cetola/pocket-reform-mirror/pocket-reform-keyboard-case/pref-kbd-stdalone-20261014-plate15.step

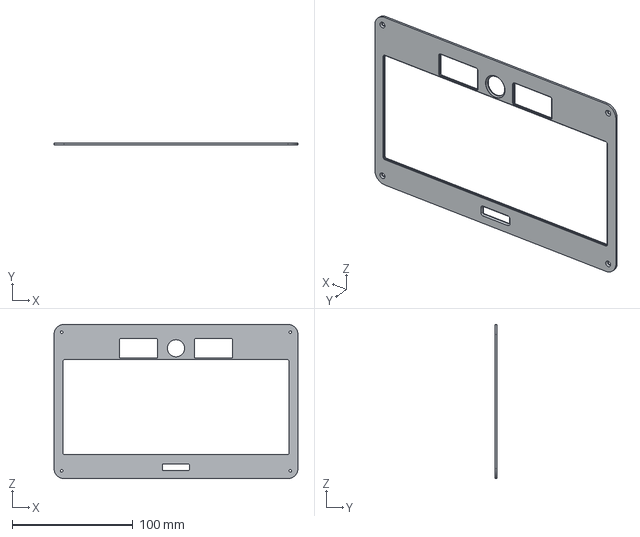
[picture p1: CAD file, 2026-10-14]
pocket-reform-keyboard-case/pref-kbd-stdalone-20261014-plate15.step
202.2 x 1.50 x 127.8 mm
