cetola/pocket-reform-mirror/pocket-reform-motherboard/3d-models/HDMI-SMD_BX-HDMI-2-M19P.step

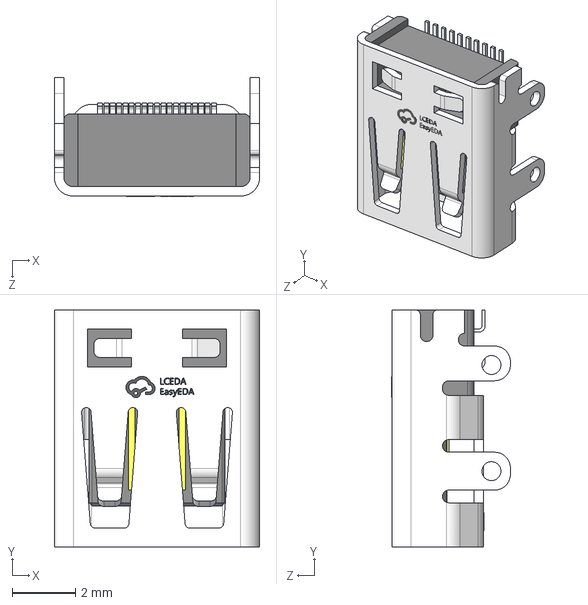
[picture p2: CAD file, 2026-08-06]
pocket-reform-motherboard/3d-models/HDMI-SMD_BX-HDMI-2-M19P.step
6.50 x 7.50 x 3.76 mm
