cetola/pocket-reform-mirror/pocket-reform-keyboard-case/pref-kbd-plate-20260616.step

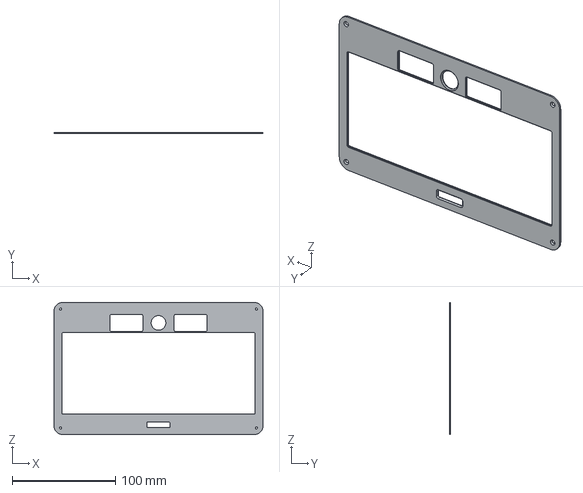
[picture p3: CAD file, 2026-10-09]
pocket-reform-keyboard-case/pref-kbd-plate-20260616.step
202.2 x 1.30 x 127.8 mm
