cetola/pocket-reform-mirror/pocket-reform-motherboard/3d-models/RET0040A.stp

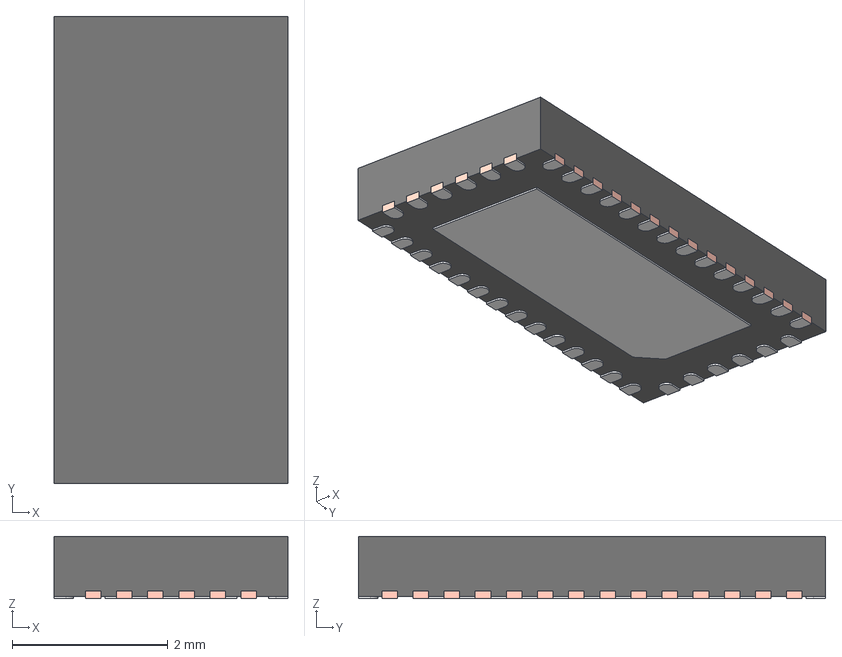
[picture p4: CAD file, 2026-08-06]
pocket-reform-motherboard/3d-models/RET0040A.stp
3.00 x 6.00 x 0.8 mm
RET0040A_FRAME
RET0040A_BODY
RET0040A_PIN1_AREA
