cetola/pocket-reform-mirror/pocket-reform-motherboard/3d-models/FUSB302BMPX.STEP

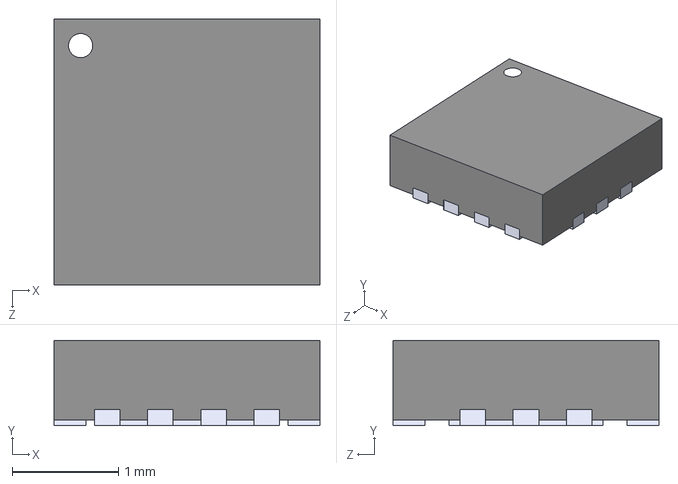
[picture p5: CAD file, 2026-08-06]
pocket-reform-motherboard/3d-models/FUSB302BMPX.STEP
2.50 x 0.8 x 2.50 mm
