cetola/pocket-reform-mirror/pocket-reform-motherboard/3d-models/LM73100RPWR.step

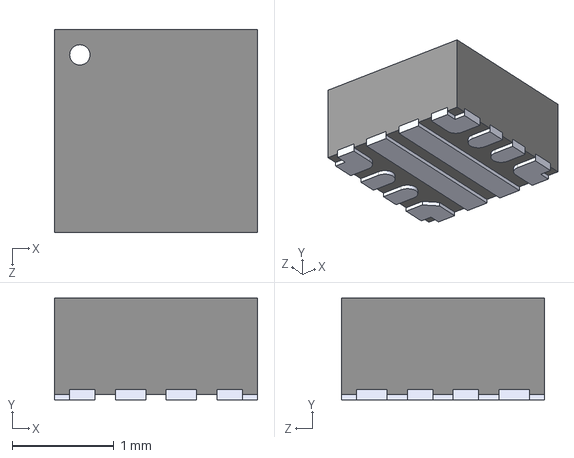
[picture p6: CAD file, 2026-08-06]
pocket-reform-motherboard/3d-models/LM73100RPWR.step
2.00 x 1.00 x 2.00 mm
