cetola/pocket-reform-mirror/pocket-reform-motherboard/3d-models/LM62460QRPHRQ1.step

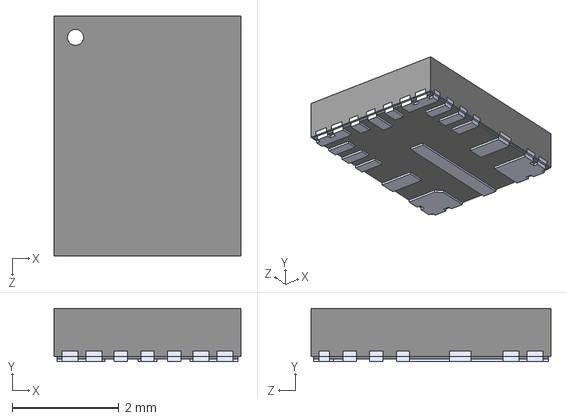
[picture p7: CAD file, 2026-08-06]
pocket-reform-motherboard/3d-models/LM62460QRPHRQ1.step
3.50 x 1.00 x 4.50 mm
