cetola/pocket-reform-mirror/pocket-reform-motherboard/pocket-reform-motherboard.kicad_pcb

## KiCad design pocket-reform-motherboard/pocket-reform-motherboard.kicad_pcb (2026-07-01)

Schematic: pocket-reform-motherboard.kicad_sch, MNT Pocket Reform

Parts:
C1, C3, C13, C19, C20, C25, C27, C28, C29, C30, C31, C32, C33, C34, C35, C38, C40, C42, C43, C44, C45, C46, C48, C49, C50, C53, C54, C55, C57, C59, C60, C61, C62, C63, C64, C66, C68, C69, C70, C71, C72, C73, C74, C75, C76, C77, C78, C79, C80, C81, C84, C87, C95, C97, C99, C101, C104, C108, C109, C121, C127, C128, C130, C131, C132, C137, C138, C142, C143, C144, C145, C148, C151, C154, C155, C156: 0.1uF; C_0402_1005Metric; LCSC C307331
C2, C7, C12, C39, C47, C51, C56, C58, C65, C98, C105, C107, C112, C115, C129, C133, C136, C141, C152, C153, C157, C158: 10uF; C_0603_1608Metric; LCSC C194427
C4: 22uF; C_Elec_4x5.4; LCSC C3830031
C5: 47uF; CP_Elec_6.3x5.8; LCSC C688950
C6, C14, C15, C16, C17, C18, C116, C117, C118, C119, C120, C134: 22uF; C_0603_1608Metric; LCSC C86295
C8, C11, C82, C113, C114: 470nF; C_0603_1608Metric; LCSC C1623
C9, C10: 4.7uF; C_0603_1608Metric; LCSC C437419
C21, C23: 18pF; C_0402_1005Metric; LCSC C1549
C22, C24: 15pF; C_0402_1005Metric; LCSC C161530
C26, C36, C111, C125, C147: 1uF; C_0402_1005Metric; LCSC C52923
C37: 1nF; C_0402_1005Metric; LCSC C1523
C41, C146: 4.7uF; C_0402_1005Metric; LCSC C23733
C52: 10nF; C_0603_1608Metric; LCSC C1589
C67, C106: 22uF; C_0805_2012Metric; LCSC C45783
C83, C123, C124, C126: 47uF; C_0603_1608Metric; LCSC C140782
C85, C86, C88, C89, C90, C91, C92, C93: 0.22uF; C_0402_1005Metric; LCSC C1525
C94, C100: 10uF; C_0402_1005Metric; LCSC C315248
C96: DNP; C_0402_1005Metric; LCSC C1525; not fitted
C102, C103, C135: 47uF; C_1206_3216Metric; LCSC C94034
C110, C122: 10pF; C_0402_1005Metric; LCSC C32949
D1, D8, D9, D23: LED_RED; LED_0603_1608Metric; LCSC C965799
D2: ESDS314; SOT-23-5; LCSC C1847859
D3: MS2A40LWS; D_SOD-323; LCSC C7380001
D5: PMEG4050EP-FS; D_SOD-128; LCSC C42387310
D10: 19-337/R6GHBHC-A01/2T; LED_19-337_R6GHBHC-A01_2T; LCSC C264519
D12: SD0603S040S0R2; D_0603_1608Metric; LCSC C143772
FB2, FB9, FB10, FB12, FB13, FB14, FB15, FB16: 100@100MHz 3A; L_0603_1608Metric; LCSC C14709
FB5: DNP; L_0603_1608Metric; LCSC C14709; not fitted
GFX1: MountingHole; pocket-reform; LCSC DNP; not fitted
GFX2: MountingHole; pref-motherboard-badge; LCSC DNP; not fitted
H1, H2, H3, H4: MountingHole_Pad; MountingHole_2.2mm_M2_DIN965_Pad; LCSC DNP; not fitted
H5, H7: NGFF-Mount1; WA-SMSI-M2; LCSC C18198647
H8, H9: MountingHole_Pad; WA-SMSI-M2; LCSC C22431115
J1: CHARGER; JST_PH_S9B-PH-SM4-TB_1x09-1MP_P2.00mm_Horizontal; LCSC C278795
J2: DM3AT-SF-PEJM5; LCSC C114218
J3, J14: USB_C_Receptacle; MOLEX_105450-0101; LCSC C134092
J4: 09452812561; LCSC C19193264
J5: SYSCTL; JST_SH_SM04B-SRSS-TB_1x04-1MP_P1.00mm_Horizontal; LCSC C160404
J6: USB_INT1; JST_SH_SM04B-SRSS-TB_1x04-1MP_P1.00mm_Horizontal; LCSC C160404
J7: HDMI_D_1.4; HDMI-SMD_BX-HDMI-2-M19P; LCSC C18077696
J8: SIM_Card; MOLEX_78800-0001; LCSC C127364
J9: Conn_01x20; Hirose_FH12-20S-0.5SH_1x20-1MP_P0.50mm_Horizontal; LCSC C2906119
J10: 1-2199230-6; TE_1-2199230-6; LCSC C4710843
J11: Conn_01x33; Hirose_FH12-33S-0.5SH_1x33-1MP_P0.50mm_Horizontal; LCSC C19077727
J12: 2199230-5; TE_2199230-5; LCSC C4827729
J13: 3-2328724-1; TE_3-2328724-1; LCSC C52722586
J15: CONN_SPK; Molex_PicoBlade_53261-0271_1x02-1MP_P1.25mm_Horizontal; LCSC C177225
J16: SAMTEC_TSM-106-02-X-SH-A; LCSC C6290784
J17: POWSW; JST_SH_SM02B-SRSS-TB_1x02-1MP_P1.00mm_Horizontal; LCSC C160402
J18: CONN_HEAD; JST_SH_SM05B-SRSS-TB_1x05-1MP_P1.00mm_Horizontal; LCSC C136657
J20: QWIIC; JST_SH_SM04B-SRSS-TB_1x04-1MP_P1.00mm_Horizontal; LCSC C160404
L1: 12uH; L_Taiyo-Yuden_NR-30xx; LCSC C167758
L2: 3.3uH; L_1210_3225Metric; LCSC C337905
L3: 3.3uH; L_Coilcraft_XAL6060-XXX; LCSC C3040366
L4: 2.2uH; L_Coilcraft_XAL6060-XXX; LCSC C167218
L5, L6: 15uH; L_Taiyo-Yuden_NR-30xx; LCSC C668450
R1, R16, R29, R34, R35, R36, R45, R58, R60, R61, R63, R71, R110, R165: 1k; R_0402_1005Metric; LCSC C11702
R2: 1M; R_0402_1005Metric; LCSC C26083
R3: 90.9K 1%; R_0402_1005Metric; LCSC C26989
R4, R5, R11, R12, R13, R19, R27, R46, R50, R53, R54, R62, R65, R66, R67, R81, R104, R105, R106, R107, R108, R109, R116, R118, R122, R123, R124, R133, R136, R139, R148, R149, R151, R152, R153, R154, R155, R164, R166, R167, R168, R169, R170: 0; R_0402_1005Metric; LCSC C17168
R6: 470k; R_0402_1005Metric; LCSC C25790
R7: 124k; R_0402_1005Metric; LCSC C36777
R10, R20, R22, R24, R26, R28, R30, R38, R44, R49, R52, R56, R68, R72, R75, R85, R94, R96, R111, R113, R114, R115, R117, R119, R121, R125, R127, R128, R130, R131, R134, R135, R138, R141, R142, R143, R144, R145, R156, R159, R160, R162, R163: 10k; R_0402_1005Metric; LCSC C25744
R14: 8.25k; R_0402_1005Metric; LCSC C95598
R15: 33k; R_0402_1005Metric; LCSC C25779
R17, R51, R69, R70, R87, R91, R112, R150, R157: 100k; R_0402_1005Metric; LCSC C25741
R18: 24.9k; R_0402_1005Metric; LCSC C25874
R21, R74, R78, R88: DNP; R_0402_1005Metric; LCSC DNP; not fitted
R23: 9.53K 1%; R_0402_1005Metric; LCSC C96273
R25, R42, R43, R57, R59, R95, R101, R120, R161: 4.7k; R_0402_1005Metric; LCSC C25900
R31: 0; R_0603_1608Metric; LCSC C21189
R32, R33, R64, R89, R93, R132, R137, R158: 2.2k; R_0402_1005Metric; LCSC C25879
R37, R39, R40, R41: 75 1%; R_0402_1005Metric; LCSC C25133
R47, R48: 27.4; R_0402_1005Metric; LCSC C31439
R55, R76, R77, R79, R80, R82, R86: 33; R_0402_1005Metric; LCSC C25105
R73, R97, R98, R99, R100: 47k; R_0402_1005Metric; LCSC C25792
R83, R84: 22k; R_0402_1005Metric; LCSC C25768
R90: 27k; R_0402_1005Metric; LCSC C25771
R92, R126: 4.99k; R_0402_1005Metric; LCSC C25903
R102: 43.2k; R_0402_1005Metric; LCSC C25894
R103: 0; R_0402_1005Metric; LCSC C17168; not fitted
R129: 6.8k; R_0402_1005Metric; LCSC C25917
R198, R199: 49.9; R_0402_1005Metric; LCSC C25120
SW1: SW_DIP_x01; SW_DIP_SPSTx01_Slide_Copal_CHS-01A_W5.08mm_P1.27mm_JPin; LCSC C3312106
SW2, SW3: RESET; SW_Push_1P1T_NO_CK_KMR2; LCSC C318893
TP1, TP2, TP3, TP4, TP5, TP6, TP10, TP11, TP12, TP13, TP14, TP15, TP16, TP17, TP18, TP19, TP20, TP21: TestPoint; TestPoint_Pad_D1.0mm; not fitted
TP7: UUART_SUSPEND; TestPoint_Pad_D1.0mm; not fitted
TP8: UUART_WAKEUP; TestPoint_Pad_D1.0mm; not fitted
TP9: UUART_nPOWER; TestPoint_Pad_D1.0mm; not fitted
TR1: TG111-MSC13LF; Transformer_Ethernet_HALO_TG111-MSC13; LCSC C501477
U1: reform2-som-connector; TE_1473149-4; LCSC C590722
U2, U30, U31, U37: TS3USB30EDGSR; VSSOP-10_3x3mm_P0.5mm; LCSC C131998
U3: LM2830XQMFE/NOPB; SOT-23-5; LCSC C2072452
U4: TLV75718PDBV; SOT-23-5; LCSC C507270
U5: LM73100RPWR; IC_LM73100RPWR; PARTREV 08/2019; LCSC C3210761
U6, U28: LM62460; CONV_LM61495QRPHRQ1; LCSC C3198091
U7: 74LVC1G34; SOT-353_SC-70-5; LCSC C353880
U8: RP2040; RP2040-QFN-56; LCSC C2040
U9: TPS7A0533PDBZ; SOT-23; LCSC C2877921
U10: W25Q32JVSS; SOIC-8_5.3x5.3mm_P1.27mm; LCSC C179173
U11: PCF8523T; SOIC-8_3.9x4.9mm_P1.27mm; LCSC C2651516
U12, U29, U32, U36, U40, U41: AP22615AWU-7; SOT-23-6; LCSC C2680357
U13, U24: TXS0108EPW; TSSOP-20_4.4x6.5mm_P0.65mm; LCSC C17206
U14: SN74AVC1T45; SOT-23-6; LCSC C131978
U15, U16, U19, U20, U21, U22: TPD4E02B04DQA; USON-10_2.5x1.0mm_P0.5mm; LCSC C2841426
U17: TPD12S521; TSSOP50P640X120-38N; LCSC C126920
U18: TLV320AIC3100; VQFN-32-1EP_5x5mm_P0.5mm_EP3.5x3.5mm; LCSC C478458
U23: FUSB302BMPX; WQFN-14-1EP_2.5x2.5mm_P0.5mm_EP1.45x1.45mm; LCSC C132291
U25: TUSB8041; QFN-64-1EP_9x9mm_P0.5mm_EP6x6mm_ThermalVias; LCSC C544686
U27: TVS2200DRV; WSON-6-1EP_2x2mm_P0.65mm_EP1x1.6mm; LCSC C523793
U33: AT24CS02-STUM; SOT-23-5; LCSC C2060969
U34: PCA9536DP; TSSOP-8_3x3mm_P0.65mm; LCSC C14674
U35: TMUXHS4446RETR; IC_TMUXHS4446RETR; PARTREV FEBRUARY 2024; LCSC C35471229
U38: CY7C65215-32LTXI; QFN-32-1EP_5x5mm_P0.5mm_EP3.45x3.45mm; LCSC C22451897
U39: PCA9557PW; TSSOP-16_4.4x5mm_P0.65mm; LCSC C141380
U42: TPS560430X3FDBVR; SOT-23-6; LCSC C2071721
Y1: 24MHz; Crystal_SMD_Abracon_ABM8G-4Pin_3.2x2.5mm; LCSC C91744
Y2: 12MHz 12pF; Crystal_SMD_3225-4Pin_3.2x2.5mm; LCSC C20625731
Y3: 32.768 kHz; Crystal_SMD_3215-2Pin_3.2x1.5mm; LCSC C48615

Connections:
3V3_ENABLE_L: R71.2, R121.2, U32.4 (EN), U39.9 (IO2)
5V_ENABLE_L: R63.2, U39.7 (IO1)
+1V1: C134.1, L2.2, R14.1, R50.1, TP15.1 (1_1)
+1V8: C10.1, C20.1, C41.1, FB12.1, J13.1, R53.1, R81.2, TP14.1 (1_1), U4.5 (OUT), U7.5 (VCC)
+3V3: C58.1, C77.1, C116.1, C117.1, C118.1, C119.1, C120.1, C133.1, C141.1, FB5.2, FB13.2, L4.2, R4.2, R24.1, R26.1, R29.1, R30.1, R34.1, R42.2, R43.2, R54.2, R85.1, R87.1, R90.1, R91.1, R92.1, R97.2, R98.2, R99.2, R100.2, R112.2, R128.2, R136.2, R154.2, R156.2, R157.1, R160.2, R164.2, TP13.1 (1_1), U28.5 (BIAS), U29.6 (IN), U36.6 (IN), U40.6 (IN)
+5V: C14.1, C15.1, C16.1, C17.1, C18.1, C39.1, C47.1, C73.2, C108.1, C136.1, D12.2 (A), FB2.1, L3.2, R3.1, R11.1, R17.1, R51.2, R62.1, R68.2, R103.2, R126.1, R142.2, TP12.1 (1_1), U1.1 (5V), U1.2 (5V), U1.3 (5V), U1.4 (5V), U1.5 (5V), U1.6 (5V), U6.5 (BIAS), U9.3 (VI), U12.6 (IN), U17.1 (5V_SUPPLY), U41.6 (IN)
/3V3_1V8: C9.1, R4.1, U4.1 (IN), U4.3 (EN)
/AUD_3V3: C50.1, C51.1, C97.1, C107.1, FB5.1, J18.1, U9.2 (VO), U18.17 (AVDD), U18.28 (HPVDD)
/DP0_N: J9.8, R148.1
/DP0_P: J9.7, R149.1
/DP1_N: J9.5, R151.1
/DP1_P: J9.4, R152.1
/DP2_N: J9.2, R169.1
/DP2_P: J9.1, R170.1
/DP3_N: J9.11, R167.1
/DP3_P: J9.10, R168.1
/DP_AUX_N: C138.2, J9.15
/DP_AUX_P: C137.2, J9.16
/M2_SMB_ALERTn: J10.44
/M2_SMB_CLK: J10.40
/M2_SMB_DATA: J10.42
/MODEM_3V3: C52.1, C53.1, C54.1, C55.1, C83.1, C123.1, J12.2, J12.4, J12.70, J12.72, J12.74, R1.1, R164.1, R166.2
/M_ANTCTL0: J12.59
/M_ANTCTL1: J12.61
/M_ANTCTL2: J12.58
/M_ANTCTL3: J12.56
/M_COEX1: J12.64
/M_COEX2: J12.62
/M_CONFIG_0: J12.21
/M_CONFIG_1: J12.69
/M_CONFIG_2: J12.75
/M_CONFIG_3: J12.1
/M_I2C_SCL: J12.38
/M_I2C_SDA: J12.68
/M_I2S_MCLK(IO): J12.60
/M_LAA_TX_EN: J12.63
/M_SIM1_DET: J12.66
/M_SIM2_CLK: J12.44
/M_SIM2_DATA: J12.42
/M_SIM2_DET: J12.40
/M_SIM2_PWR: J12.48
/M_SIM2_RESET: J12.46
/M_VIO_1V8: J12.65
/PCIE_3V3: C59.1, C60.1, C61.1, C124.1, C126.1, J10.2, J10.4, J10.12, J10.14, J10.16, J10.18, J10.70, J10.72, J10.74, R110.1, U29.1 (OUT)
/RRUD+: R47.1, U8.47 (USB_DP)
/RRUD-: R48.1, U8.46 (USB_DM)
/RUD+: R47.2, U2.3 (D2+), U30.4 (D+)
/RUD-: R48.2, U2.7 (D2-), U30.6 (D-)
/SYSLED_B: R61.1, U8.18 (GPIO15)
/SYSLED_G: R58.1, U8.28 (GPIO17)
/SYSLED_R: R60.1, U8.27 (GPIO16)
/USB1_C_RXN: C128.2, U25.56 (USB_SSTXM_UP)
/USB1_C_RXP: C127.2, U25.55 (USB_SSTXP_UP)
/USBH_1A_AC_TXN: C85.1, J3.A3 (TX1-), U20.4 (IO3), U20.7 (IO3)
/USBH_1A_AC_TXP: C88.1, J3.A2 (TX1+), U20.5 (IO4), U20.6 (IO4)
/USBH_1B_AC_TXN: C86.1, J3.B3 (TX2-), U22.1 (IO1), U22.10 (IO1)
/USBH_1B_AC_TXP: C89.1, J3.B2 (TX2+), U22.2 (IO2), U22.9 (IO2)
/USBM1_AC_RXN: J14.B10 (RX1-), U19.1 (IO1), U19.10 (IO1), U35.25 (CRX1+)
/USBM1_AC_RXP: J14.B11 (RX1+), U19.2 (IO2), U19.9 (IO2), U35.24 (CRX1-)
/USBM1_AC_TXN: C90.2, J14.A3 (TX1-), U19.4 (IO3), U19.7 (IO3)
/USBM1_AC_TXP: C92.2, J14.A2 (TX1+), U19.5 (IO4), U19.6 (IO4)
/USBM1_TXN: C92.1, U35.27 (CTX1-)
/USBM1_TXP: C90.1, U35.28 (CTX1+)
/USBM2_AC_RXN: J14.A10 (RX2-), U21.1 (IO1), U21.10 (IO1), U35.34 (CRX2+)
/USBM2_AC_RXP: J14.A11 (RX2+), U21.2 (IO2), U21.9 (IO2), U35.33 (CRX2-)
/USBM2_AC_TXN: C91.2, J14.B3 (TX2-), U21.4 (IO3), U21.7 (IO3)
/USBM2_AC_TXP: C93.2, J14.B2 (TX2+), U21.5 (IO4), U21.6 (IO4)
/USBM2_TXN: C93.1, U35.30 (CTX2-)
/USBM2_TXP: C91.1, U35.31 (CTX2+)
/USBM_SBU1: J14.A8 (SBU1), U35.22 (SBU1)
/USBM_SBU2: J14.B8 (SBU2), U35.21 (SBU2)
/USB_UART_3V3: C146.1, R134.1, R135.1, R136.1, U38.1 (VDDD), U38.19 (VBUS), U38.23 (VDDD)
/VCONN: R166.1, U23.12 (VCONN), U23.13 (VCONN)
/VIN_FOR_3V3: C112.1, C113.1, C114.1, C115.1, U28.2 (VIN2), U28.14 (VIN1), U32.1 (OUT)
/XUD+: U2.4 (D+), U31.3 (D2+)
/XUD-: U2.6 (D-), U31.7 (D2-)
/~M_LED1: D1.1 (K), J12.10
/~M_W_DISABLE1: J12.8, R65.1
/~M_W_DISABLE2: J12.26, R66.1
/~PCIE2_CLKREQ: J12.52
/~PCIE2_WAKE: J12.54
CHG_VCC: C4.1, J1.1, J1.2, R6.1, U5.5 (IN)
DAC_BCLK: R76.1, U1.170 (SAI2_TXC)
DAC_DIN: R79.1, U1.166 (SAI2_RXD)
DAC_DOUT: R77.1, U1.178 (SAI2_TXD)
DAC_MCLK: R82.2, U1.176 (SAI2_MCLK)
DAC_SCL: R42.1, U1.101 (I2C3_SCL), U11.6 (SCL), U18.10 (SCL)
DAC_SDA: R43.1, U1.103 (I2C3_SDA), U11.5 (SDA), U18.9 (SDA)
DAC_TXFS: R80.1, U1.172 (SAI2_TXFS)
DISP_1BL_2EN: J13.26, U1.105 (GPIO1_IO10)
DISP_1EN_2BL: J13.2, R46.2, R138.1, R139.2
DISP_2_PWM: R139.1, U8.9 (GPIO7)
DISP_BACKLIGHT_3V3: C105.1, J13.5, J13.6, J13.28, J13.29, J13.30, J13.31, R138.2, U36.1 (OUT)
DISP_BL_PWR_EN_L: R130.2, U36.4 (EN), U39.12 (IO5)
DP_HPD: J9.17, R165.2
DSI_CLK_N: J11.19, J13.17
DSI_CLK_P: J11.20, J13.16
DSI_D0_N: J11.25, J13.20
DSI_D0_P: J11.26, J13.19
DSI_D1_N: J11.22, J13.14
DSI_D1_P: J11.23, J13.13
DSI_D2_N: J11.16, J13.11
DSI_D2_P: J11.17, J13.10
DSI_D3_N: J11.13, J13.23
DSI_D3_P: J11.14, J13.22
ETH0_A+: TR1.2 (TD1+), U1.29 (TRX0_P)
ETH0_A-: TR1.3 (TD1-), U1.27 (TRX0_N)
ETH0_B+: TR1.5 (TD2+), U1.23 (TRX1_P)
ETH0_B-: TR1.6 (TD2-), U1.21 (TRX1_N)
ETH0_C+: TR1.8 (TD3+), U1.17 (TRX2_P)
ETH0_C-: TR1.9 (TD3-), U1.15 (TRX2_N)
ETH0_D+: TR1.11 (TD4+), U1.11 (TRX3_P)
ETH0_D-: TR1.12 (TD4-), U1.9 (TRX3_N)
ETH0_DA+: J4.1, TR1.23 (MTX1+)
ETH0_DA-: J4.2, TR1.22 (MTX1-)
ETH0_DB+: J4.6, TR1.20 (MTX2+)
ETH0_DB-: J4.7, TR1.19 (MTX2-)
ETH0_DC+: J4.4, TR1.17 (MTX3+)
ETH0_DC-: J4.5, TR1.16 (MTX3-)
ETH0_DD+: J4.9, TR1.14 (MX4+)
ETH0_DD-: J4.10, TR1.13 (MX4-)
ETH0_LED_LINK1: D9.1 (K), U1.83 (JTAG_TDO)
ETH0_LED_RX: D8.1 (K), U1.79 (JTAG_MOD)
GND: C1.2, C2.2, C3.2, C4.2, C5.2, C6.2, C7.2, C8.2, C9.2, C10.2, C11.2, C12.2, C13.1, C14.2, C15.2, C16.2, C17.2, C18.2, C20.2, C21.2, C22.2, C23.2, C24.2, C25.2, C26.2, C27.2, C28.2, C29.2, C30.2, C31.2, C32.2, C33.2, C34.2, C35.2, C36.2, C37.2, C38.2, C39.2, C40.2, C41.2, C42.2, C43.2, C44.2, C45.2, C46.1, C47.2, C48.2, C49.2, C52.2, C53.2, C54.2, C55.2, C56.2, C58.2, C59.2, C60.2, C61.2, C62.2, C63.2, C64.2, C65.2, C66.2, C68.2, C69.2, C70.2, C71.2, C72.1, C73.1, C74.2, C75.2, C77.2, C79.2, C80.2, C81.2, C83.2, C84.2, C87.2, C94.2, C95.1, C98.2, C100.2, C101.2, C105.2, C108.2, C111.1, C112.2, C113.2, C114.2, C115.2, C116.2, C117.2, C118.2, C119.2, C120.2, C123.2, C124.2, C125.1, C126.2, C129.2, C130.2, C131.2, C132.1, C133.2, C134.2, C135.2, C136.2, C141.2, C142.2, C143.2, C144.2, C145.2, C146.2, C147.2, C148.2, C151.2, C152.2, C153.2, C154.1, C155.1, C156.1, C157.2, C158.2, D2.2 (A), D3.2 (A), D10.1 (RK), D10.2 (GK), D10.3 (BK), FB14.1, FB15.1, FB16.1, H1.1 (1_1), H2.1 (1_1), H3.1 (1_1), H4.1 (1_1), H5.1 (1_1), H7.1 (1_1), H8.1 (1_1), H9.1 (1_1), J1.8, J1.9, J2.6 (VSS), J2.P1 (SHIELD), J2.P2 (SHIELD), J2.P3 (SHIELD), J2.P4 (SHIELD), J2.SWA (DET_A), J3.A1 (GND), J3.A12 (GND), J3.B1 (GND), J3.B12 (GND), J3.S1 (SHIELD), J4.3, J4.8, J4.SH, J5.4, J6.4, J7.4 (D2S), J7.7 (D1S), J7.10 (D0S), J7.13 (CKS), J7.16 (GND), J7.20 (SH), J8.5 (GND), J8.P1 (SHIELD), J8.P2 (SHIELD), J8.P3 (SHIELD), J8.P4 (SHIELD), J9.3, J9.6, J9.9, J9.12, J9.13, J10.1, J10.3, J10.9, J10.15, J10.21, J10.27, J10.33, J10.39, J10.45, J10.51, J10.57, J10.71, J10.73, J10.75, J10.S1 (SHIELD), J10.S2 (SHIELD), J11.1, J11.2, J11.12, J11.15, J11.18, J11.21, J11.24, J11.27, J11.30, J12.3, J12.5, J12.11, J12.27, J12.33, J12.39, J12.45, J12.51, J12.57, J12.71, J12.73, J12.SH1 (SHIELD), J12.SH2 (SHIELD), J13.3, J13.4, J13.9, J13.12, J13.15, J13.18, J13.21, J13.24, J13.27, J13.S1 (Pin_32), J13.S2 (Pin_33), J14.A1 (GND), J14.A12 (GND), J14.B1 (GND), J14.B12 (GND), J14.S1 (SHIELD), J16.1, J16.4, J17.1, J20.1, R10.2, R15.2, R16.2, R18.2, R20.2, R22.2, R23.1, R32.2, R33.2, R49.1, R69.2, R73.2, R94.2, R95.1, R96.2, R101.1, R102.2, R104.2, R105.2, R106.2, R107.2, R108.2, R109.2, R115.2, R120.2, R121.1, R125.2, R129.2, R130.1, R141.2, R143.1, R144.1, R145.1, R150.2, R158.2, R159.1, R161.2, R162.1, R198.1, R199.1, SW1.2, SW2.2 (B), SW3.2 (B), TP3.1 (1_1), TP19.1 (1_1), U1.7 (GND), U1.13 (GND), U1.19 (GND), U1.25 (GND), U1.31 (GND), U1.41 (GND), U1.44 (GND), U1.47 (GND), U1.50 (GND), U1.53 (GND), U1.56 (GND), U1.59 (GND), U1.62 (GND), U1.65 (GND), U1.68 (GND), U1.71 (GND), U1.74 (GND), U1.80 (GND), U1.94 (GND), U1.95 (GND), U1.98 (GND), U1.99 (GND), U1.104 (GND), U1.110 (GND), U1.111 (GND), U1.116 (GND), U1.117 (GND), U1.123 (GND), U1.129 (GND), U1.161 (GND), U1.167 (GND), U1.173 (GND), U1.179 (GND), U1.185 (GND), U1.191 (GND), U2.5 (GND), U3.2 (GND), U4.2 (GND), U5.8 (GND), U6.1 (PGND2), U6.8 (AGND), U6.12 (SYNC/MODE), U6.15 (PGND1), U7.3 (GND), U8.19 (TESTEN), U8.57 (GND), U9.1 (GND), U10.4 (GND), U11.4 (VSS), U12.2 (GND), U13.11 (GND), U14.2 (GND), U15.3 (G), U15.8 (G), U16.3 (G), U16.8 (G), U17.3 (GND), U17.5 (TMDS_GND), U17.8 (TMDS_GND), U17.11 (TMDS_GND), U17.14 (TMDS_GND), U17.25 (TMDS_GND), U17.28 (TMDS_GND), U17.31 (TMDS_GND), U17.34 (TMDS_GND), U17.36 (GND), U18.1 (IOVSS), U18.18 (DVSS), U19.3 (G), U19.8 (G), U20.3 (G), U20.8 (G), U21.3 (G), U21.8 (G), U22.3 (G), U22.8 (G), U23.8 (GND), U23.9 (GND), U23.15 (GND), U24.11 (GND), U25.65 (VSS), U27.1 (GND), U27.2 (GND), U27.3 (GND), U27.7 (GND), U28.1 (PGND2), U28.8 (AGND), U28.12 (SYNC/MODE), U28.15 (PGND1), U29.2 (GND), U30.5 (GND), U31.5 (GND), U32.2 (GND), U33.2 (GND), U33.5 (WP), U34.4 (VSS), U35.15 (GND), U35.18 (GND), U35.37 (GND), U35.41 (GND), U36.2 (GND), U37.5 (GND), U38.4 (VSSD), U38.17 (VSSD), U38.20 (VSSD), U38.24 (VSSA), U39.4 (A1), U39.5 (A2), U39.8 (VSS), U40.2 (GND), U41.2 (GND), U42.2 (GND), Y1.2, Y1.4, Y2.2, Y2.4
GNDA: C50.2, C51.2, C57.2, C67.2, C76.2, C78.2, C96.1, C97.2, C99.2, C106.2, C107.2, FB14.2, FB15.2, FB16.2, J18.5, U18.16 (AVSS), U18.20 (SPKVSS), U18.25 (SPKVSS), U18.29 (HPVSS), U18.33 (EP)
HDMI_AUXN: U1.189 (HDMI_AUX_N)
HDMI_AUXP: U1.187 (HDMI_AUX_P)
HDMI_CEC: R100.1, U1.197 (HDMI_CEC), U17.16 (CE_REMOTE_IN)
HDMI_CLKN: J7.14 (CK-), U1.163 (HDMI_CLK_N), U17.15 (TMDS_CK-), U17.24 (TMDS_CK-)
HDMI_CLKP: J7.12 (CK+), U1.165 (HDMI_CLK_P), U17.13 (TMDS_CK+), U17.26 (TMDS_CK+)
HDMI_HPD: R97.1, U1.199 (HDMI_HPD), U17.19 (HOTPLUG_DET_IN)
HDMI_SCL: R98.1, U1.195 (HDMI_DDC_SCL), U17.17 (DDC_CLK_IN)
HDMI_SDA: R99.1, U1.193 (HDMI_DDC_SDA), U17.18 (DDC_DAT_IN)
HDMI_TX0N: J7.11 (D0-), U1.169 (HDMI_TX0_N), U17.12 (TMDS_D0-), U17.27 (TMDS_D0-)
HDMI_TX0P: J7.9 (D0+), U1.171 (HDMI_TX0_P), U17.10 (TMDS_D0+), U17.29 (TMDS_D0+)
HDMI_TX1N: J7.8 (D1-), U1.175 (HDMI_TX1_N), U17.9 (TMDS_D1-), U17.30 (TMDS_D1-)
HDMI_TX1P: J7.6 (D1+), U1.177 (HDMI_TX1_P), U17.7 (TMDS_D1+), U17.32 (TMDS_D1+)
HDMI_TX2N: J7.5 (D2-), U1.181 (HDMI_TX2_N), U17.6 (TMDS_D2-), U17.33 (TMDS_D2-)
HDMI_TX2P: J7.3 (D2+), U1.183 (HDMI_TX2_P), U17.4 (TMDS_D2+), U17.35 (TMDS_D2+)
HEAD_HPL: C103.2, J18.3
HEAD_HPR: C102.2, J18.4
HEAD_MIC: C96.2, C104.2, J18.2, R64.1, U18.11 (VOL/MICDET)
HUB_PWR_EN_L: R162.2, U39.10 (IO3), U40.4 (EN)
IMX_RESETn: R30.2, U1.87 (EXT_RESET_N)
IMX_RTC_IRQ: R67.1, U1.141 (RTC_IRQ)
IMX_UART1_RX: J16.5, R26.2, R134.2, U1.126 (UART1_RXD), U38.30 (SCB0_4/GPIO_5)
IMX_UART1_TX: J16.6, U1.128 (UART1_TXD), U38.2 (SCB0_0/GPIO_8)
IMX_UART2_RX: J16.2, R24.2, R135.2, U1.122 (UART2_RXD), U38.6 (SCB1_1/GPIO_11)
IMX_UART2_TX: J16.3, U1.124 (UART2_TXD), U38.5 (SCB1_0/GPIO_10)
IMX_WAKE: U1.145 (GPIO1_IO3), U8.30 (GPIO19)
KICKSTART: R44.2, R45.2, SW3.1 (A)
LPC_MISO: TP11.1 (1_1), U1.93 (ECSPI2_MISO), U8.14 (GPIO11)
LPC_MOSI: TP5.1 (1_1), U1.91 (ECSPI2_MOSI), U8.11 (GPIO8)
LPC_SCK: TP10.1 (1_1), U1.97 (ECSPI2_SCLK), U8.13 (GPIO10)
LPC_SS0: TP6.1 (1_1), U1.89 (ECSPI2_SS0), U8.12 (GPIO9)
MODEM_PWROFFn: J12.6, U8.29 (GPIO18)
MODEM_RESET: J12.67, U24.6 (A5)
MODEM_RESET_3V3: U8.31 (GPIO20), U24.15 (B5)
unnamed: C24.1, R35.1, Y2.3
unnamed: C37.1, R37.2, R39.2, R40.2, R41.2
unnamed: C57.1, C67.1, C99.1, C106.1, FB2.2, U18.21 (SPKVDD), U18.24 (SPKVDD)
unnamed: C110.2, R126.2
unnamed: C122.2, R92.2
unnamed: D1.2 (A), R1.2
unnamed: D3.1 (K), L2.1, U3.1 (SW)
unnamed: D8.2 (A), R29.2
unnamed: D9.2 (A), R34.2
unnamed: D10.4 (BA), R61.2
unnamed: D10.5 (GA), R60.2
unnamed: D10.6 (RA), R58.2
unnamed: D12.1 (K), R89.1, R93.1
unnamed: D23.2 (A), R110.2
unnamed: D23.1 (K), J10.10
unnamed: FB9.1, U18.22 (SPKP), U18.26 (SPKP)
unnamed: FB9.2, L5.1
unnamed: FB10.1, U18.19 (SPKM), U18.23 (SPKM)
unnamed: FB10.2, L6.1
unnamed: J2.5 (CLK), U14.4 (B)
unnamed: C63.1, C64.1, C65.1, C66.1, J2.4 (VDD), R154.1, U13.19 (VCCB), U14.6 (VCCB)
unnamed: J3.A5 (CC1), R83.1, U16.1 (IO1), U16.10 (IO1)
unnamed: J3.B5 (CC2), R84.1, U16.2 (IO2), U16.9 (IO2)
unnamed: J6.1, R62.2
unnamed: C87.1, J7.19 (+5V), U17.38 (5V_OUT)
unnamed: J7.15 (CEC), R90.2, U17.23 (CE_REMOTE_OUT)
unnamed: J7.1 (HPD/HEAC-), R96.1, U17.20 (HOTPLUG_DET_OUT)
unnamed: J7.17 (SCL), R89.2, U17.22 (DDC_CLK_OUT)
unnamed: J7.18 (SDA), R93.2, U17.21 (DDC_DAT_OUT)
unnamed: J9.18, J9.19, J9.20, R103.1
unnamed: J10.11, R107.1
unnamed: J10.13, R104.1
unnamed: J10.23, R108.1
unnamed: J10.25, R105.1
unnamed: J10.35, R109.1
unnamed: J10.37, R106.1
unnamed: J14.A5 (CC1), TP20.1 (1_1), U15.1 (IO1), U15.10 (IO1), U23.10 (CC1), U23.11 (CC1)
unnamed: J14.B5 (CC2), TP21.1 (1_1), U15.2 (IO2), U15.9 (IO2), U23.1 (CC2), U23.14 (CC2)
unnamed: C76.1, C82.1, J15.1, L5.2
unnamed: C78.1, C82.2, J15.2, L6.2
unnamed: R40.1, TR1.21 (MCT2)
unnamed: R39.1, TR1.18 (MCT3)
unnamed: R37.1, TR1.15 (MCT4)
unnamed: R41.1, TR1.24 (MTC1)
unnamed: C42.1, TR1.1 (TCT1)
unnamed: C43.1, TR1.4 (TCT2)
unnamed: C44.1, TR1.7 (TCT3)
unnamed: C45.1, TR1.10 (TCT4)
unnamed: R116.1, U1.139 (FAST_BOOT)
unnamed: R74.2, U1.180 (SAI3_MCLK/PWM4)
unnamed: R88.2, U1.200 (SAI3_RXC)
unnamed: R21.2, U1.198 (SAI3_RXFS)
unnamed: R86.2, U1.192 (SAI3_TXC)
unnamed: R55.2, U1.190 (SAI3_TXFS)
unnamed: R78.2, U1.164 (SPDIF_RX/PWM2)
unnamed: R13.1, U1.32 (UART3_RXD)
unnamed: R12.2, U1.30 (UART3_TXD)
unnamed: R153.1, U1.137 (UART4_RXD)
unnamed: R11.2, U1.118 (USB1_VBUS)
unnamed: R163.2, U3.4 (EN)
unnamed: R10.1, R14.2, U3.3 (FB)
unnamed: R27.2, R163.1, U3.5 (Vin)
unnamed: R6.2, R7.1, U5.1 (EN/UVLO)
unnamed: R16.1, U5.9 (IMON)
unnamed: R7.2, R15.1, U5.2 (OVLO)
unnamed: C19.1, U6.3 (RBOOT), U6.4 (CBOOT)
unnamed: R63.1, R125.1, U6.13 (EN)
unnamed: C110.1, R17.2, R18.1, U6.7 (FB)
unnamed: R51.1, U6.10 (RESET)
unnamed: C111.2, U6.6 (VCC), U6.9 (RT), U6.11 (SPSP)
unnamed: C19.2, L3.1, U6.16 (SW)
unnamed: R165.1, U8.36 (GPIO24)
unnamed: R45.1, U8.37 (GPIO25)
unnamed: C26.1, C28.1, C29.1, C151.1, U8.23 (DVDD), U8.45 (VREG_VOUT), U8.50 (DVDD)
unnamed: C22.1, U8.20 (XIN), Y2.1
unnamed: R35.2, U8.21 (XOUT)
unnamed: U11.1 (OSCI), Y3.1
unnamed: U11.2 (OSCO), Y3.2
unnamed: R19.1, U11.3 (VBAT)
unnamed: R67.2, U11.7 (~INT1/CLKOUT)
unnamed: R68.1, U12.3 (FLG)
unnamed: R32.1, U12.5 (ISET)
unnamed: R75.2, U13.10 (OE), U14.5 (DIR)
unnamed: C48.1, C49.1, R75.1, R81.1, U13.2 (VCCA), U14.1 (VCCA)
unnamed: C72.2, U17.37 (ESD_BYP)
unnamed: R85.2, U17.2 (LV_SUPPLY)
unnamed: R76.2, U18.7 (BCLK)
unnamed: R77.2, U18.5 (DIN)
unnamed: R79.2, U18.4 (DOUT)
unnamed: C56.1, C62.1, FB12.2, R70.2, U18.3 (DVDD)
unnamed: C103.1, U18.27 (HPL)
unnamed: C102.1, U18.30 (HPR)
unnamed: C95.2, C98.1, FB13.1, U18.2 (IOVDD)
unnamed: R82.1, U18.8 (MCLK)
unnamed: C104.1, U18.14 (MIC1RP)
unnamed: R64.2, U18.12 (MICBIAS)
unnamed: R80.2, U18.6 (WCLK)
unnamed: R70.1, U18.31 (~RESET)
unnamed: R52.2, U24.10 (OE)
unnamed: C68.1, R28.1, R52.1, R53.2, U24.2 (VCCA)
unnamed: C69.1, R54.1, U24.19 (VCCB)
unnamed: R25.1, U25.40 (FULLPWRMGMTz/SMBA1/SS_UP)
unnamed: R101.2, U25.42 (GANGED/SMBA2/HS_UP)
unnamed: R5.1, U25.50 (GRSTz)
unnamed: R95.2, U25.49 (TEST)
unnamed: R23.2, U25.64 (USB_R1)
unnamed: R3.2, R22.1, U25.48 (USB_VBUS)
unnamed: C23.1, R2.2, U25.62 (XI), Y1.3
unnamed: C21.1, R2.1, U25.61 (XO), Y1.1
unnamed: C121.1, U28.3 (RBOOT), U28.4 (CBOOT)
unnamed: R71.1, R94.1, U28.13 (EN)
unnamed: C122.1, R91.2, R102.1, U28.7 (FB)
unnamed: R112.1, U28.10 (RESET)
unnamed: C125.2, U28.6 (VCC), U28.9 (RT), U28.11 (SPSP)
unnamed: C121.2, L4.1, U28.16 (SW)
unnamed: R156.1, U29.3 (FLG)
unnamed: R158.1, U29.5 (ISET)
unnamed: R119.1, U32.3 (FLG)
unnamed: R120.1, U32.5 (ISET)
unnamed: R122.1, U34.1 (IO0)
unnamed: R123.1, U34.2 (IO1)
unnamed: R124.1, U34.3 (IO2)
unnamed: R115.1, R118.1, U34.5 (IO3)
unnamed: R144.2, U35.14 (A0)
unnamed: R145.2, U35.35 (CONF0/A1)
unnamed: R111.1, U35.1 (MODE0)
unnamed: R127.1, U35.13 (MODE1)
unnamed: R128.1, U36.3 (FLG)
unnamed: R129.1, U36.5 (ISET)
unnamed: C145.1, R133.2, U37.10 (VCC)
unnamed: TP9.1 (1_1), U38.31 (GPIO_6)
unnamed: TP7.1 (1_1), U38.11 (SUSPEND)
unnamed: C147.1, U38.16 (VCCD)
unnamed: TP8.1 (1_1), U38.12 (WAKEUP)
unnamed: R132.2, U39.3 (A0)
unnamed: R46.1, U39.6 (IO0)
unnamed: R155.2, U39.14 (IO7)
unnamed: R137.2, U39.15 (~RESET)
unnamed: R160.1, U40.3 (FLG)
unnamed: R161.1, U40.5 (ISET)
unnamed: R142.1, U41.3 (FLG)
unnamed: R33.1, U41.5 (ISET)
unnamed: C109.2, U42.1 (CB)
unnamed: C109.1, L1.1, U42.6 (SW)
PCIE1_CLKREQn: J10.52, R153.2
PCIE1_CLK_N: J10.53, R199.2, U1.60 (PCIE1_REFCLK_N)
PCIE1_CLK_P: J10.55, R198.2, U1.58 (PCIE1_REFCLK_P)
PCIE1_RESETn: J10.50, U1.37 (PCIE_RST_B)
PCIE1_RX_N: J10.41, U1.54 (PCIE1_RX_N)
PCIE1_RX_P: J10.43, U1.52 (PCIE1_RX_P)
PCIE1_TX_N: J10.47, U1.48 (PCIE1_TX_N)
PCIE1_TX_P: J10.49, U1.46 (PCIE1_TX_P)
PCIE2_CLK_N: U1.66 (PCIE2_REFCLK_N)
PCIE2_CLK_P: U1.64 (PCIE2_REFCLK_P)
PCIE2_RESETn: U1.24 (WIFI_RESET)
PCIE2_RX_N: U1.78 (PCIE2_RX_N)
PCIE2_RX_P: U1.76 (PCIE2_RX_P)
PCIE2_TX_N: U1.72 (PCIE2_TX_N)
PCIE2_TX_P: U1.70 (PCIE2_TX_P)
PCIE_PWR_EN_L: R159.2, U29.4 (EN), U39.13 (IO6)
PHONE_CLK: J12.20, U24.1 (A1)
PHONE_CLK_3V3: R74.1, R86.1, R88.1, U24.20 (B1)
PHONE_DIN: J12.22, U24.3 (A2)
PHONE_DIN_3V3: U1.196 (SAI3_TXD), U24.18 (B2)
PHONE_DOUT: J12.24, U24.4 (A3)
PHONE_DOUT_3V3: U1.194 (SAI3_RXD), U24.17 (B3)
PHONE_DPR: J12.25, U24.8 (A7)
PHONE_DPR_3V3: U8.39 (GPIO27_ADC1), U24.13 (B7)
PHONE_SYNC: J12.28, U24.5 (A4)
PHONE_SYNC_3V3: R21.1, R55.1, U24.16 (B4)
PROG: R36.1, SW1.1
QSPI_CS: R36.2, R38.2, U8.56 (QSPI_SS), U10.1 (~CS)
QSPI_SCK: U8.52 (QSPI_SCLK), U10.6 (CLK)
QSPI_SD0: U8.53 (QSPI_SD0), U10.5 (DI(IO0))
QSPI_SD1: U8.55 (QSPI_SD1), U10.2 (DO(IO1))
QSPI_SD2: U8.54 (QSPI_SD2), U10.3 (IO2)
QSPI_SD3: U8.51 (QSPI_SD3), U10.7 (IO3)
RESET: R56.2, SW2.1 (A), U8.26 (RUN)
RP_FLIGHTMODE: R65.2, R66.2, U8.5 (GPIO3)
RP_FUSB_INT: U8.17 (GPIO14), U23.5 (INT_N)
RP_SCL0: D2.4 (K), J1.7, J20.4, R57.1, U8.3 (GPIO1), U23.6 (SCL), U33.1 (SCL), U34.6 (SCL), U35.36 (CONF1/SCL), U39.1 (SCL)
RP_SDA0: D2.3 (K), J1.6, J20.3, R59.1, U8.2 (GPIO0), U23.7 (SDA), U33.3 (SDA), U34.7 (SDA), U35.38 (CONF2/SDA), U39.2 (SDA)
RP_UART1_RX: J5.3, U8.7 (GPIO5)
RP_UART1_TX: J5.2, U8.6 (GPIO4)
RP_UART2_RX: R12.1, U8.16 (GPIO13)
RP_UART2_TX: R13.2, U8.15 (GPIO12)
SDC_CMD: J2.3 (CMD), U13.20 (B1)
SDC_D0: J2.7 (DAT0), U13.15 (B5)
SDC_D1: J2.8 (DAT1), U13.16 (B4)
SDC_D2: J2.1 (DAT2), U13.17 (B3)
SDC_D3: J2.2 (DAT3/CD), U13.18 (B2)
SD_CLK: U1.22 (SD2_CLK), U14.3 (A)
SD_CMD: U1.20 (SD2_CMD), U13.1 (A1)
SD_D0: U1.12 (SD2_DATA0), U13.6 (A5)
SD_D1: U1.14 (SD2_DATA1), U13.5 (A4)
SD_D2: U1.16 (SD2_DATA2), U13.4 (A3)
SD_D3: U1.18 (SD2_DATA3), U13.3 (A2)
SD_DET: J2.SWB (DET_B), R87.2, U1.26 (SD2_CD)
STANDBY_3V3: C13.2, C25.1, C27.1, C30.1, C31.1, C32.1, C33.1, C34.1, C35.1, C36.1, C40.1, C46.2, C130.1, C131.1, C132.2, C135.1, C142.1, C143.1, C144.1, C148.1, C154.2, C155.2, C156.2, J1.5, J5.1, J20.2, L1.2, R19.2, R38.1, R44.1, R56.1, R57.2, R59.2, R111.2, R113.1, R114.1, R117.2, R127.2, R131.2, R132.1, R133.1, R137.1, TP1.1 (1_1), U2.10 (VCC), U8.1 (IOVDD), U8.10 (IOVDD), U8.22 (IOVDD), U8.33 (IOVDD), U8.42 (IOVDD), U8.43 (ADC_AVDD), U8.44 (VREG_IN), U8.48 (USB_VDD), U8.49 (IOVDD), U10.8 (VCC), U11.8 (VDD), U23.3 (VDD), U23.4 (VDD), U30.10 (VCC), U31.10 (VCC), U33.4 (VCC), U34.8 (VDD), U35.4 (VCC), U35.7 (VCC), U35.10 (VCC), U35.23 (VCC), U35.26 (VCC), U35.29 (VCC), U35.32 (VCC), U39.16 (VDD), U42.3 (FB)
SWC: TP2.1 (1_1), U8.24 (SWCLK)
SWD: TP4.1 (1_1), U8.25 (SWD)
SYS_VCC: C2.1, C5.1, C7.1, C8.1, C11.1, C12.1, C129.1, D5.1 (K), R72.1, R119.2, TP18.1 (1_1), U5.6 (OUT), U6.2 (VIN2), U6.14 (VIN1), U32.6 (IN), U42.5 (VIN)
UART_U+: U37.3 (D2+), U38.14 (USBDP)
UART_U-: U37.7 (D2-), U38.15 (USBDM)
UIM_CLK: J8.3 (CLK), J12.32
UIM_IO: J8.7 (I/O), J12.34
UIM_PWR: J8.1 (VCC), J12.36
UIM_RST: J8.2 (RST), J12.30
UIM_VPP: J8.6 (VPP)
USB1_DN: U1.100 (USB1_D_N), U25.54 (USB_DM_UP)
USB1_DP: U1.102 (USB1_D_P), U25.53 (USB_DP_UP)
USB1_RXN: C128.1, U1.112 (USB1_RX_N)
USB1_RXP: C127.1, U1.114 (USB1_RX_P)
USB1_TXN: U1.106 (USB1_TX_N), U25.59 (USB_SSRXM_UP)
USB1_TXP: U1.108 (USB1_TX_P), U25.58 (USB_SSRXP_UP)
USB2_DN: U1.125 (USB2_D_N), U2.8 (D1-), U30.8 (D1-)
USB2_DP: U1.127 (USB2_D_P), U2.2 (D1+), U30.2 (D1+)
USB2_RXN: U1.121 (USB2_RX_N)
USB2_RXP: U1.119 (USB2_RX_P)
USB2_TXN: U1.115 (USB2_TX_N)
USB2_TXP: U1.113 (USB2_TX_P)
USBH_1A_RXN: J3.B10 (RX1-), U20.1 (IO1), U20.10 (IO1), U25.7 (USB_SSRXM_DN1)
USBH_1A_RXP: J3.B11 (RX1+), U20.2 (IO2), U20.9 (IO2), U25.6 (USB_SSRXP_DN1)
USBH_1A_TXN: C85.2, U25.4 (USB_SSTXM_DN1)
USBH_1A_TXP: C88.2, U25.3 (USB_SSTXP_DN1)
USBH_1B_RXN: J3.A10 (RX2-), U22.4 (IO3), U22.7 (IO3), U25.22 (USB_SSRXP_DN3)
USBH_1B_RXP: J3.A11 (RX2+), U22.5 (IO4), U22.6 (IO4), U25.23 (USB_SSRXM_DN3)
USBH_1B_TXN: C86.2, U25.19 (USB_SSTXP_DN3)
USBH_1B_TXP: C89.2, U25.20 (USB_SSTXM_DN3)
USBH_1V1: C1.1, C3.1, C70.1, C71.1, C74.1, C79.1, C81.1, C100.1, C101.1, R50.2, U25.5 (VDD), U25.8 (VDD), U25.13 (VDD), U25.21 (VDD), U25.28 (VDD), U25.31 (VDD), U25.51 (VDD), U25.57 (VDD)
USBH_1_DN: U25.2 (USB_DM_DN1), U31.8 (D1-)
USBH_1_DP: U25.1 (USB_DP_DN1), U31.2 (D1+)
USBH_2A_RXN: U25.15 (USB_SSRXM_DN2), U35.16 (SSRX+)
USBH_2A_RXP: U25.14 (USB_SSRXP_DN2), U35.17 (SSRX-)
USBH_2A_TXN: U25.12 (USB_SSTXM_DN2), U35.12 (SSTX-)
USBH_2A_TXP: U25.11 (USB_SSTXP_DN2), U35.11 (SSTX+)
USBH_2_DN: U25.10 (USB_DM_DN2), U37.8 (D1-)
USBH_2_DP: U25.9 (USB_DP_DN2), U37.2 (D1+)
USBH_3V3: C6.1, C38.1, C75.1, C80.1, C84.1, C94.1, R25.2, R27.1, U25.16 (VDD33), U25.34 (VDD33), U25.52 (VDD33), U25.63 (VDD33), U40.1 (OUT)
USBH_3_DN: J6.2, U25.18 (USB_DM_DN3)
USBH_3_DP: J6.3, U25.17 (USB_DP_DN3)
USBH_4_DN: J12.9, U25.25 (USB_DM_DN4)
USBH_4_DP: J12.7, U25.24 (USB_DP_DN4)
USBM_DP0_N: R148.2, U35.39 (DP0+)
USBM_DP0_P: R149.2, U35.40 (DP0-)
USBM_DP1_N: R151.2, U35.2 (DP1+)
USBM_DP1_P: R152.2, U35.3 (DP1-)
USBM_DP2_N: R169.2, U35.5 (DP2+)
USBM_DP2_P: R170.2, U35.6 (DP2-)
USBM_DP3_N: R167.2, U35.8 (DP3+)
USBM_DP3_P: R168.2, U35.9 (DP3-)
USBM_DP_AUX_N: C138.1, R157.2, U35.20 (AUX-)
USBM_DP_AUX_P: C137.1, R150.1, U35.19 (AUX+)
USB_LOADER_SW: R116.2, U8.38 (GPIO26_ADC0)
USB_P1_DN: J14.A7 (D-), J14.B7 (D-), U15.4 (IO3), U15.7 (IO3), U37.6 (D-)
USB_P1_DP: J14.A6 (D+), J14.B6 (D+), U15.5 (IO4), U15.6 (IO4), U37.4 (D+)
USB_P2_DN: J3.A7 (D-), J3.B7 (D-), U16.4 (IO3), U16.7 (IO3), U31.6 (D-)
USB_P2_DP: J3.A6 (D+), J3.B6 (D+), U16.5 (IO4), U16.6 (IO4), U31.4 (D+)
USB_SRC1_EN: R143.2, U8.40 (GPIO28_ADC2), U41.4 (EN)
USB_SRC2_EN: R49.2, U8.41 (GPIO29_ADC3), U12.4 (EN)
USB_VBUS: C157.1, C158.1, J14.A4 (VBUS), J14.A9 (VBUS), J14.B4 (VBUS), J14.B9 (VBUS), R31.2, TP16.1 (1_1), U23.2 (VBUS), U27.4 (IN), U27.5 (IN), U27.6 (IN), U41.1 (OUT)
USB_VBUS2: C152.1, C153.1, J3.A4 (VBUS), J3.A9 (VBUS), J3.B4 (VBUS), J3.B9 (VBUS), R83.2, R84.2, TP17.1 (1_1), U12.1 (OUT)
USWITCH_1: R117.1, R122.2, U31.1 (S)
USWITCH_2: R114.2, R123.2, U2.1 (S)
USWITCH_3: R113.2, R124.2, U30.1 (S)
USWITCH_4: R118.2, R131.1, U37.1 (S)
USWITCH_OFF: R141.1, R155.1, U2.9 (~OE), U30.9 (~OE), U31.9 (~OE), U37.9 (~OE)
VCHG: D5.2 (A), J1.3, J1.4, R31.1
WOWWAN: J12.23, R28.2, U24.7 (A6)
WOWWAN_3V3: U8.8 (GPIO6), U24.14 (B6)
~DISP_RESET_1V8: J13.8, R73.1, U7.4
~DISP_RESET_L: R20.1, U7.2, U39.11 (IO4)
~DISP_RESET: U8.4 (GPIO2)
~STANDBY_SHDN: J17.2, R72.2, U42.4 (~SHDN)
~USBH_RESET: R5.2, R69.1, U1.131 (USB_HUB_RESET)

Notes on the sheet:
MAX 28V
open drain
Power Rails
RP2040 has 3.3V IO
3V3
DP0
NOT 1-2199230-5!
Rff
default must be for flashing the rp2040 from the outside. rp2040 can then switch this to other functions.
- Display V1: Backlight is digitally controlled - Display V2: Backlight is PWMed by RP2040 on DISP_EN_L pin
TSOT-23-6
Rfbt
To headphone PCB
DP1
close to VREG_OUT
3v3 I2C Mode
MCLK+BCLK are the same for the modem (CLK). all clocks can be bidrectional.
1V8 -> 3V3
PERp1
MAX 36V
PETp1
place near RP2040
GPIO bank controlled via I2C by System Controller
N/P swapped
PERp3
TODO: AC?
SSD M.2 Card Slot
ILIM (A) = 6800/RLIM (Ω)
Realtime Clock
BRINGUP: confirm these new tx caps
1Gb Ethernet
MIPI-DSI / Display Connector
DisplayPort Alt-Mode Mux
on display v2: HiZ on display v1: low to turn off display
has 10k pulldown (active low)
New in V1.5
Cff
WARNING: do not use B version by accident (active low)
LATER: pci2 unconnected
SWD Debug
SOURCE
GPIO43
S=0: D=D1 S=1: D=D2
SOC USB recovery port - UUU on i.MX8MP - EDL on QUASAR - BootRom/xrock on RK3588
Keystone 2998 C238096
UART to KBD
BRINGUP: adjust ISET 2.0 R-1: 6.8k/1A was too tight for SSD in tests. switched to 2.2k on board (3A ~ 9.9W)
Charger Interface
PERn2
Calculated: OV rising = 22.67V OV falling = 20.78V UV rising = 4.79V UV falling = 4.39V
JDI LT070ME05000
PETp3
1.25mm pitch Molex Picoblade
Power to charger
2.0 R-1 change
Status LED
or: Heling MT24-S1T1
Pol. swap
USB Hub
4V-36V
M Key 42H M.2
1V8 OD
note: changed from 4.7k in V2.0
PERp2
ILIM (A) = 6800/RLIM (Ω) = ~1.45A
Notes: chip can latch ovlo state. power cycle to reset.
iX Industrial 10B-1
UART to SOC
has 10k pulldown
LATER: test which of these are required
automatic charger board bypass
Serial Ports
default
PETn1
2280 formfactor
2.0 R-1: polarity swapped to undo the swap on output side
Hard Powerdown Interface
1473149-4 is incompatible! the correct one is 1473149-1! (or 1717254-1)
compat: TI PCA9536DGKR
MicroSD Slot
downstream of USBH_3V3
=1.095V
TE 3-2328724-1
Flipped vertically vs D-1
unused on V2.0
DCDC_EN
note: cap only connection
External port 1 USB 2.0
LATER: can't turn off 3v3 without resetting
LATER: wire up clock request on quasar+rk3588
Heatsink/SOM Mount
Power from charger
SPI test points
1V8
Port Protection
Phone Level Shifter
Rfbb
1-2199230-5
TODO: leftover USB pins
Switch for 2nd USB routing
to kbd/trackball
DisplayPort
PERn1
2.0 R-1 change: include a 5V switch to USB_VBUS. charger board v2 can't use otg because of the protector chip
GPIO41
1V1
2.0 R-1: adds lane 2+3
PETp2
(note: vqfn and qfn have different pinouts)
External port 2 USB 2.0
SFV33R-1STBE1HLF
TX caps are on the SoM
Sysctl GPIO Bank
GPIO44
Level Shifter
B Key M.2
USB-C port 1 with PD charging
System Controller
GPIO3
1V8/3V3
WWAN M.2 Card Slot
LATER: any current limiting / monitoring here?
I2C lines pulled up by SYS 3v3 power near DAC
PETn3
on display v1: HiZ on display v2: PWM the backlight (overpower R138)
Internal USB/UART (Keyboard/TB Interface)
TODO: DP AC on this lane vs DP1
Powered by main batteries in standby
Bossie BX-HDMI-2-M19P
To charger (SINK/SOURCE)
close to VREG_IN
XRES
2.0 R-1 change: USB SRC1/2 split
HPD signal for eDP
rated to 28V
ideal diode ->
to modem
LATER: D5 with less dropout (part selection)
Qwiic I2C Interface
BRINGUP: split these signals?
no AC caps here as they are on the device
pulled up on card
USB-C port 2
SoM Interface
FH35C-31S-0.3HW(50) (HIROSE)
LATER: unconnected
2.0 R-1: DP1 swapped too, like all others
Alt: Foxconn AS0BC21-S40BB-7H
PETn2
I2C control bus
PERn3
2.0 R-1 change: VCONN. MODEM_3V3 is convenient on the PCB
P0 is open drain!
Charger: MP2650
note: 100k in datasheet
I2C addresses on RP2040 bus: 0x18: PCA9557 (gpios) 0x22: FUSB302B (usb-c cc) 0x36/0x0b: MAX17320 (prot/monitor) 0x50/0x58: AT24CS02-STUM (eeprom) 0x54: TMUXHS4446 0x5c: MP2650 (charger)
Example: SIMCOM sim8262e
LATER: limit?
LATER: move to sysctl
22k = 1.5A @ 5V limit
Micro HDMI Port
GPIO77
GPIO40
VCCIO supply for level shifter, LCM
Includes ESD protection
SD VCC
NOTE: Not flipped, use opposite side FPC cable only!
CEC

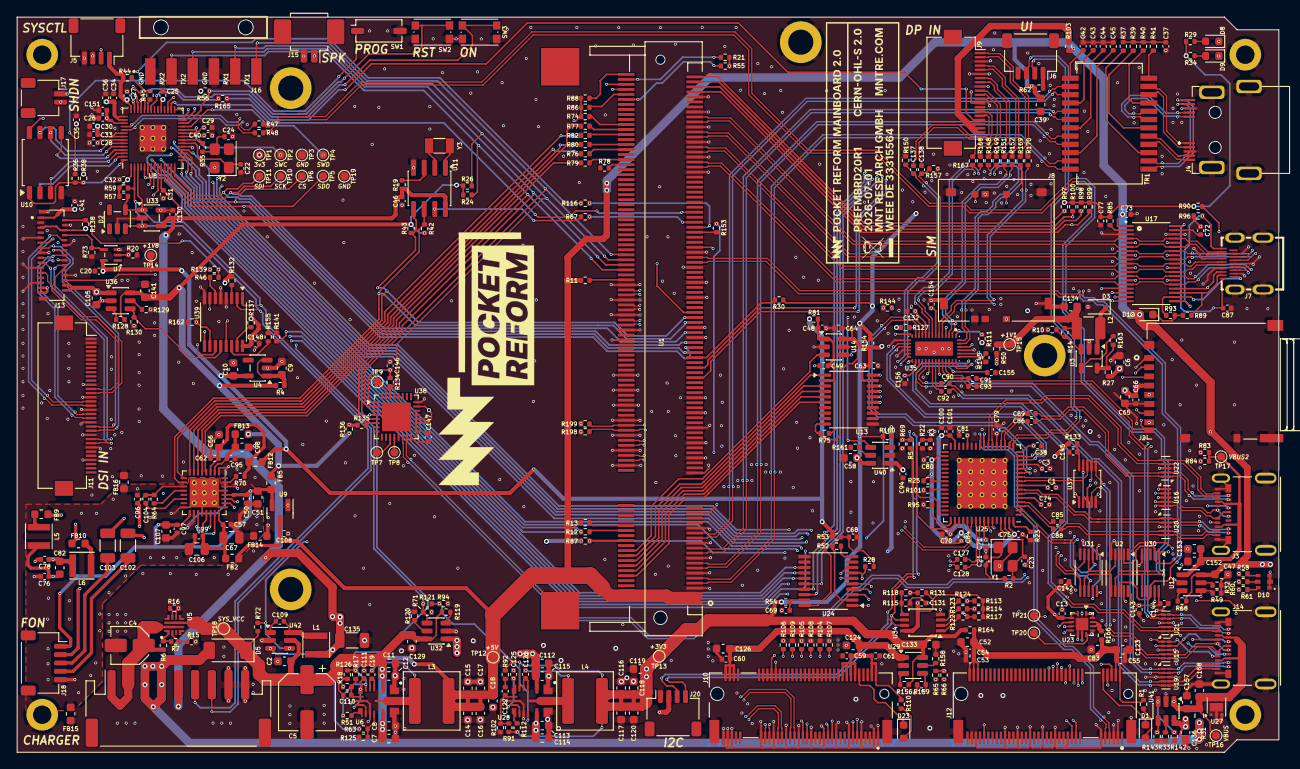
[picture p8: board pocket-reform-motherboard.kicad_pcb from above]

Board: 6 copper layers, 151.0 x 88.0 mm, 443 parts (0 on the bottom side), 392 nets.
