cetola/pocket-reform-mirror/pocket-reform-wifi/pocket-reform-wifi.kicad_pcb

## KiCad design pocket-reform-wifi/pocket-reform-wifi.kicad_pcb (2026-08-05)

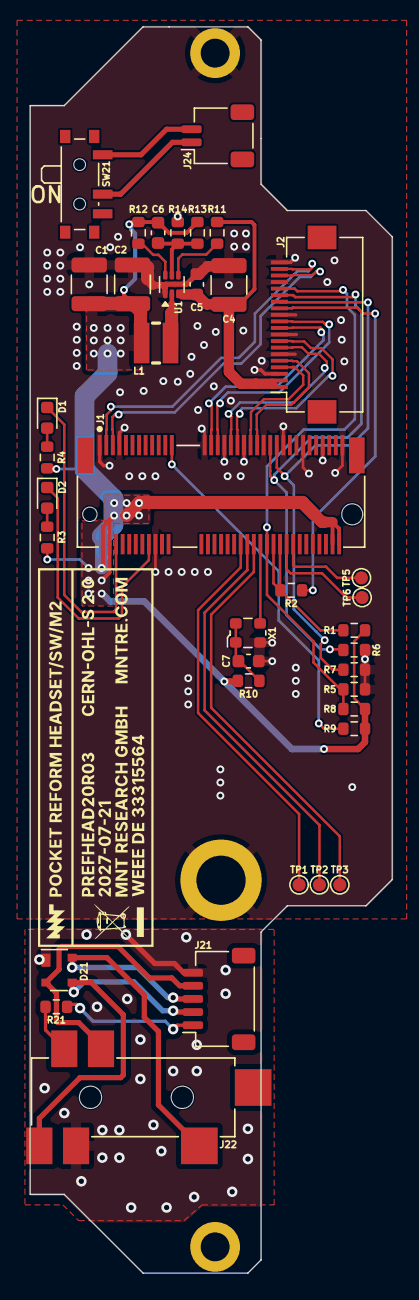
[picture p9: board pocket-reform-wifi.kicad_pcb from above]

Board: 4 copper layers, 27.6 x 95.0 mm, 42 parts (0 on the bottom side), 40 nets.

Parts:
C1, C2: 47uF; C_1210_3225Metric
C4: 10uF; C_1210_3225Metric
C5: 4.7nF; C_0603_1608Metric
C6: 120pF; C_0603_1608Metric
C7: 0.1uF; C_0603_1608Metric
D1, D2: LED_Small; LED_0603_1608Metric
D21: SP0503BAHT; SOT-143
GFX21: BADGE; pref-headset-badge-r3
H1: MountingHole_Pad; Mounting_Sinhoo_SMTSO20
H21, H22: MountingHole_Pad; MountingHole_2.2mm_M2_DIN965_Pad
J1: Bus_M.2_Socket_E; TE_2199119-4
J2: Conn_01x20; Hirose_FH12-20S-0.5SH_1x20-1MP_P0.50mm_Horizontal
J21: CONN_HEAD; JST_SH_SM05B-SRSS-TB_1x05-1MP_P1.00mm_Horizontal
J22: SJ-43516-SMT
J24: CONN_PWRSW; JST_SH_SM02B-SRSS-TB_1x02-1MP_P1.00mm_Horizontal
L1: 220nH 10A; IND-SMD_L3.0-W3.0_FTC303020D
R1, R5, R6, R7, R8, R9: 10k; R_0603_1608Metric
R2, R10, R11: 0; R_0603_1608Metric
R3, R4: 2k; R_0603_1608Metric
R12: 499k; R_0603_1608Metric
R13: 453k; R_0603_1608Metric
R14: 100k; R_0603_1608Metric
R21: 47k; R_0603_1608Metric
SW21: SW_DIP_x01; SW_SPDT_PCM12
TP1, TP2, TP3, TP5, TP6: TestPoint; TestPoint_Pad_D1.0mm
U1: TPS62A04ABDRL; SOT-563
X1: ECS-327MVATX-2-CN-TR3; Oscillator_SMD_ECS_2520MV-xxx-xx-4Pin_2.5x2.0mm

Connections:
+3.3VDAC: J21.1, R21.1
+3V3: C1.1, C2.1, C6.1, J1.2 (3.3V), J1.4 (3.3V), J1.72 (3.3V), J1.74 (3.3V), L1.2, R1.1, R3.1, R4.1, R8.1, R9.1, R10.2, R12.1, R13.1
+5V: C4.1, C5.1, J2.1, J2.2, R11.2, U1.3 (VIN)
GND: C1.2, C2.2, C4.2, C5.2, C7.2, H1.1, H21.1, J1.1 (GND), J1.7 (GND), J1.18 (GND), J1.33 (GND), J1.39 (GND), J1.45 (GND), J1.51 (GND), J1.57 (GND), J1.63 (GND), J1.69 (GND), J1.75 (GND), J2.3, J2.6, J2.9, J2.12, J2.17, J2.20, R5.2, R6.2, R7.2, R14.2, U1.1 (GND), X1.2 (GND)
GNDA: D21.1 (A), J21.5, J22.4 (RING2)
HEAD_DET: J22.6 (RING_SWITCH), R21.2
HEAD_HPL: D21.4 (K), J21.3, J22.2 (TIP)
HEAD_HPR: D21.2 (K), J21.4, J22.3 (RING1)
HEAD_MIC: D21.3 (K), J21.2, J22.1 (SLEEVE)
unnamed: D1.2 (A), R4.2
unnamed: D1.1 (K), J1.6 (~LED_1)
unnamed: D2.2 (A), R3.2
unnamed: D2.1 (K), J1.16 (~LED_2)
unnamed: J1.48 (COEX1), TP3.1
unnamed: J1.46 (COEX2), TP2.1
unnamed: J1.44 (COEX3), TP1.1
unnamed: J1.60 (I2C_CLK), TP5.1
unnamed: J1.58 (I2C_DATA), TP6.1
unnamed: J1.23 (~SDIO_RESET), R9.2
unnamed: J1.54 (~W_DISABLE2), J1.56 (~W_DISABLE1), R1.2, R2.2
unnamed: J24.1, SW21.2
unnamed: J24.2, SW21.1
unnamed: R11.1, U1.4 (EN)
unnamed: C6.2, R13.2, R14.1, U1.5 (FB)
unnamed: R12.2, U1.6 (PG)
unnamed: L1.1, U1.2 (SW)
unnamed: C7.1, R10.1, X1.1 (Tri-State), X1.4 (VDD)
PCIE3_CLK_N: J1.49 (REFCLKn0), J2.5
PCIE3_CLK_P: J1.47 (REFCLKp0), J2.4
PCIE3_RX_N: J1.43 (PERn0), J2.8
PCIE3_RX_P: J1.41 (PERp0), J2.7
PCIE3_TX_N: J1.37 (PETn0), J2.11
PCIE3_TX_P: J1.35 (PETp0), J2.10
RK_WIFI_GPIO0: J1.52 (~PERST0), J2.16, R5.1, R8.2
RK_WIFI_GPIO1: J1.53 (~CLKREQ0), J2.15, R6.1
RK_WIFI_GPIO2: J1.55 (~PEWAKE0), J2.14, R7.1
RK_WIFI_GPIO3: J2.13, R2.1
SUSCLK: J1.50 (SUSCLK), X1.3 (OUT)
USB_N: J1.5 (USB_D-), J2.18
USB_P: J1.3 (USB_D+), J2.19
