cetola/pocket-reform-mirror/pocket-reform-sysctl-fw/src/fusb302b.c

/*
 * PD Buddy Firmware Library - USB Power Delivery for everyone
 * Copyright 2017-2018 Clayton G. Hobbs
 *
 * Licensed under the Apache License, Version 2.0 (the "License");
 * you may not use this file except in compliance with the License.
 * You may obtain a copy of the License at
 *
 *     http://www.apache.org/licenses/LICENSE-2.0
 *
 * Unless required by applicable law or agreed to in writing, software
 * distributed under the License is distributed on an "AS IS" BASIS,
 * WITHOUT WARRANTIES OR CONDITIONS OF ANY KIND, either express or implied.
 * See the License for the specific language governing permissions and
 * limitations under the License.
 */

#include "fusb302b.h"
#include <sysctl.h>
#include <stdio.h>
#include <pd.h>

bool fusb_probe() {
  uint8_t rxdata[2];
  sysctl_disable_irqs();
  bool res = i2c_read_timeout_us(i2c0, FUSB_ADDR, rxdata, 1, false, I2C_TIMEOUT);
  sysctl_enable_irqs();
  return res;
}

bool fusb_read_buf(uint8_t addr, uint8_t size, uint8_t *buf) {
  sysctl_disable_irqs();
  if (1 != i2c_write_timeout_us(i2c0, FUSB_ADDR, &addr, 1, true, I2C_TIMEOUT)) {
    return false;
  }
  int res = i2c_read_timeout_us(i2c0, FUSB_ADDR, buf, size, false, I2C_TIMEOUT);
  sysctl_enable_irqs();
  return size == res;
}

bool fusb_write_byte(uint8_t addr, uint8_t byte) {
  sysctl_disable_irqs();
  uint8_t buf[2] = {addr, byte};
  int res = i2c_write_timeout_us(i2c0, FUSB_ADDR, buf, 2, false, I2C_TIMEOUT);
  sysctl_enable_irqs();
  return 2 == res;
}

bool fusb_write_buf(uint8_t addr, uint8_t size, const uint8_t *buf) {
  sysctl_disable_irqs();
  uint8_t txbuf[size + 1];
  txbuf[0] = addr;
  for (int i = 0; i < size; i++) {
    txbuf[i + 1] = buf[i];
  }
  int res = i2c_write_timeout_us(i2c0, FUSB_ADDR, txbuf, size + 1, false, I2C_TIMEOUT);
  sysctl_enable_irqs();
  return size + 1 == res;
}

bool fusb_send_message(const union pd_msg *msg) {
  /* Token sequences for the FUSB302B */
  static uint8_t sop_seq[5] = {
    FUSB_FIFO_TX_SOP1,
    FUSB_FIFO_TX_SOP1,
    FUSB_FIFO_TX_SOP1,
    FUSB_FIFO_TX_SOP2,
    FUSB_FIFO_TX_PACKSYM
  };
  static const uint8_t eop_seq[4] = {
    FUSB_FIFO_TX_JAM_CRC,
    FUSB_FIFO_TX_EOP,
    FUSB_FIFO_TX_TXOFF,
    FUSB_FIFO_TX_TXON
  };

  /* Get the length of the message: a two-octet header plus NUMOBJ four-octet
   * data objects */
  uint8_t msg_len = 2 + 4 * PD_NUMOBJ_GET(msg);

  /* Set the number of bytes to be transmitted in the packet */
  sop_seq[4] = FUSB_FIFO_TX_PACKSYM | msg_len;

  /* Write all three parts of the message to the TX FIFO */
  bool success = fusb_write_buf(FUSB_FIFOS, 5, sop_seq);
  if (!success) {
    return false;
  }
  success = fusb_write_buf(FUSB_FIFOS, msg_len, msg->bytes);
  if (!success) {
    return false;
  }
  return fusb_write_buf(FUSB_FIFOS, 4, eop_seq);
}

bool fusb_send_message_prime(const union pd_msg *msg) {
  /* Token sequences for the FUSB302B */
  static uint8_t sop_seq[5] = {
    FUSB_FIFO_TX_SOP1,
    FUSB_FIFO_TX_SOP1,
    FUSB_FIFO_TX_SOP3,
    FUSB_FIFO_TX_SOP3,
    FUSB_FIFO_TX_PACKSYM
  };
  static const uint8_t eop_seq[4] = {
    FUSB_FIFO_TX_JAM_CRC,
    FUSB_FIFO_TX_EOP,
    FUSB_FIFO_TX_TXOFF,
    FUSB_FIFO_TX_TXON
  };

  /* Get the length of the message: a two-octet header plus NUMOBJ four-octet
   * data objects */
  uint8_t msg_len = 2 + 4 * PD_NUMOBJ_GET(msg);

  /* Set the number of bytes to be transmitted in the packet */
  sop_seq[4] = FUSB_FIFO_TX_PACKSYM | msg_len;

  /* Write all three parts of the message to the TX FIFO */
  bool success = fusb_write_buf(FUSB_FIFOS, 5, sop_seq);
  if (!success) {
    return false;
  }
  success = fusb_write_buf(FUSB_FIFOS, msg_len, msg->bytes);
  if (!success) {
    return false;
  }
  return fusb_write_buf(FUSB_FIFOS, 4, eop_seq);
}

bool fusb_send_message_prime_prime(const union pd_msg *msg) {
  /* Token sequences for the FUSB302B */
  static uint8_t sop_seq[5] = {
    FUSB_FIFO_TX_SOP1,
    FUSB_FIFO_TX_SOP3,
    FUSB_FIFO_TX_SOP1,
    FUSB_FIFO_TX_SOP3,
    FUSB_FIFO_TX_PACKSYM
  };
  static const uint8_t eop_seq[4] = {
    FUSB_FIFO_TX_JAM_CRC,
    FUSB_FIFO_TX_EOP,
    FUSB_FIFO_TX_TXOFF,
    FUSB_FIFO_TX_TXON
  };

  /* Get the length of the message: a two-octet header plus NUMOBJ four-octet
   * data objects */
  uint8_t msg_len = 2 + 4 * PD_NUMOBJ_GET(msg);

  /* Set the number of bytes to be transmitted in the packet */
  sop_seq[4] = FUSB_FIFO_TX_PACKSYM | msg_len;

  /* Write all three parts of the message to the TX FIFO */
  bool success = fusb_write_buf(FUSB_FIFOS, 5, sop_seq);
  if (!success) {
    return false;
  }
  success = fusb_write_buf(FUSB_FIFOS, msg_len, msg->bytes);
  if (!success) {
    return false;
  }
  return fusb_write_buf(FUSB_FIFOS, 4, eop_seq);
}

bool fusb_read_message(union pd_msg *msg) {
  uint8_t rxb[4] = {0};

  /* If this isn't an SOP message, return error.
   * Because of our configuration, we should be able to assume this means the
   * buffer is empty, and not try to read past a non-SOP message. */
  // TODO: [zeha] check if the above comment is really true
  if (!fusb_read_buf(FUSB_FIFOS, 1, rxb)) {
    return false;
  }
  if (rxb[0] == 0) {
    return false;
  }
  uint8_t token = (rxb[0] & FUSB_FIFO_RX_TOKEN_BITS);
  if (token != FUSB_FIFO_RX_SOP && token != FUSB_FIFO_RX_SOP1 && token != FUSB_FIFO_RX_SOP2) {
    printf("# [fusb] rxb = 0x%02x - skipping\n", rxb[0]);
    return false;
  }

  /* Read the message header into msg */
  if (!fusb_read_buf(FUSB_FIFOS, 2, msg->bytes)) {
    return false;
  }
  /* Get the number of data objects */
  uint8_t numobj = PD_NUMOBJ_GET(msg);
  /* If there is at least one data object, read the data objects */
  // uncomment for debugging
  /*printf("# [fusb] rxb 0x%02x msgtype 0x%02x msgid %d role %s numobj %d size %d\n",
         rxb[0], PD_MSGTYPE_GET(msg), PD_MESSAGEID_GET(msg), PD_POWERROLE_STR(msg), numobj, numobj * 4);*/
  if (numobj > 0) {
    if (!fusb_read_buf(FUSB_FIFOS, numobj * 4, msg->bytes + 2)) {
      return false;
    }
  }
  /* Throw the CRC32 in the garbage, since the PHY already checked it. */
  return fusb_read_buf(FUSB_FIFOS, 4, rxb);
}
