cetola/pocket-reform-mirror/(commit log)

2026-04-10 add key-value store sketch with SPI interface; add mb2.0 usb mux SPI interface
2026-04-10 add .clang-format; format src/uart_com.c
2026-04-10 WIP: kv store implementation for uart interface
2026-05-09 WIP: SC: wire up CLI to HWAPI and USB ACM commands
2026-05-11 SC: debug the CLI over uart, voltage reporting and rail toggling works
2026-05-12 SC: change spi handling to CS interrupt driven, improve timing (works)
2026-05-12 SC: manage CLI instance per i/o (spi,uart,usb); legacy kbd api compat
2026-05-12 SC: vars and units fixes, void funcs
    [cli.c, cli.h, hwapi_pocket.c, spi_com.c]
2026-06-05 sc: make backlight pwm freq editable
2026-06-19 sc: fix set-usb arity
    [hwapi_pocket.c]
2026-06-19 sc: WIP: implement switches for mb2 vs 1
2026-06-19 sc: WIP: implement switches for mb2 in pd_com
2026-06-19 sc: WIP: implement switches for mb2 in hwapi_pocket
2026-06-27 WIP hacking: fix syscon warm boot after update
    [ext_gpio.c, sysctl.c]
2026-06-27 WIP fix usb mux default config after warm boot/fw update
    [ext_gpio.c, ext_gpio.h, sysctl.c]
2026-06-29 WIP sysctl: handle a lot of missing SRC states; several usb-c alt-mode adapters work now
    [altmode.c, fusb302b.c, hwapi_pocket.c, pd_com.c, pd_com.h, sysctl.c]
2026-06-30 sysctl: fix whitespace; support HPD output for DP alt-mode
    [pd_com.c, sysctl.c]
2026-06-30 mb2.0: snapshot before rev2
    [pocket-reform-motherboard.kicad_sch]
2026-06-30 mainboard: 2.0 R-1 schematic with USB and DP fixes
    [pocket-reform-motherboard.kicad_sch]
2026-06-30 mainboard 2.0 r-1 polished
    [pocket-reform-motherboard.kicad_pcb, pocket-reform-motherboard.kicad_sch]
2026-06-30 mb2.0: component updates
    [pocket-reform-motherboard.kicad_pcb, pocket-reform-motherboard.kicad_sch]
2026-07-01 mb2.0 r-1: last minute 3v3 standby dcdc change
    [pocket-reform-motherboard.kicad_pcb, pocket-reform-motherboard.kicad_sch]
2026-07-14 WIP: PD debugging: robust attach/vdm of xreal glasses
2026-07-16 sysctl: pd_com: fix charging/comms through active cables
    [pd_com.c]
2026-07-16 sysctl: ignore sop1/2 for now, fixes Dell monitor charging
    [pd_com.c]
2026-07-17 sysctl: pd_com: more cleanups, fix a bunch of states
    [fusb302b.c, pd_com.c]
2026-07-17 sysctl fw: fix the legacy fw version display
    [hwapi_pocket.c]
2026-07-17 sysctl: fix cppcheck style and logic bugs
    [cli.c, cli.h, hwapi_pocket.c, pd_com.c, spi_com.c, sysctl.c]
2026-07-17 keyboard-fw: fix cppcheck errors
    [edit.c]
2026-07-17 keyboard 2.0: fix LEDs at poweron
    [leds.c]
2026-07-17 SC: control usb port 2 mode in power off/on, remove some cruft
2026-07-17 sc: display v2 brightness curve, fix flicker on some displays
    [hwapi_pocket.c, spi_com.c]
2026-07-18 keyboard-fw: poweron led tweaks
2026-07-18 keyboard fw: fix led poweron issues for real
    [menu.c]
2026-07-21 wifi/headset board: move screw holes by -0.5mm for better fit (r3)
    [pocket-reform-wifi.kicad_pcb]
2026-07-28 sysctl: trigger SPI processing on rising edge instead of falling
2026-07-28 sysctl: reduce i2c timeout to 20ms from 500ms to prevent crashes when called via SPI
    [sysctl.h]
2026-07-31 sysctl-fw: manage IRQs in all I2C transactions to prevent crashes during SPI interrupt servicing; fix legacy fw version lookup commands
    [altmode.c, ext_gpio.c, fusb302b.c, fusb302b.h, hwapi_pocket.c, max17320.c, mp2650.c, pd_com.c]
2026-08-01 sysctl-fw: fix control flow errors found by cppcheck
    [ext_gpio.c]
2026-08-01 sysctl/pd: fix message header bugs
    [pd.h, pd_com.c]
2026-08-01 sysctl/pd: trigger alt-mode after data role swap
    [pd_com.c]
2026-08-05 sysctl-fw: gate dispv2 backlight pwm function behind virtual gpio 8, to be enabled by panel driver
2026-08-06 keyboard-fw: fix leftover key input when entering console from menu
    [edit.c]
2026-08-06 sysctl-fw: fix dispv2 backlight lock/unlock on warm/cool boot
    [hwapi_pocket.c, sysctl.c, sysctl.h]
2026-08-06 sysctl-fw: backlight unlock fix
    [sysctl.c]
2026-08-06 sysctl-fw: simpler way to handle dispv2 backlight unlock across fw update warm reset
    [hwapi_pocket.c, sysctl.c, sysctl.h]
2026-08-07 keyboard-fw: fix long press to powerup
    [main.c]
2026-08-07 keyboard-fw: fix menu closing when lifting hyper before enter key after entering menu
    [main.c]
2026-08-07 sysctl-fw: PD: give up SRC mode after 5 tries to make active cables/adapter configurations more reliable
2026-08-12 sysctl: limit disp v2 max brightness a tiny bit more to prevent flicker on some panels/flex adapters
    [hwapi_pocket.c]
2026-08-18 sysctl-fw: auto-control backlight during dispv2 panel reset
    [hwapi_pocket.c, sysctl.c, sysctl.h]
2026-08-26 keyboard-fw: implement HID Boot Protocol for bootloader keyboard support
    Barebox's usb_kbd.c driver expects a device to respond to SET_PROTOCOL
    by switching to the classic 8 byte boot keyboard report, no Report ID,
    keyboard only. This firmware never declared boot capability
    (HID_ITF_PROTOCOL_NONE) and never reacted to protocol changes, so
    barebox had to carry a separate driver just to talk to this keyboard.
    Declare HID_ITF_PROTOCOL_KEYBOARD so the interface advertises Boot
    Interface Subclass. TinyUSB's core HID class driver already tracks
    the active protocol mode from SET_PROTOCOL requests on its own,
    tud_hid_get_protocol() reflects it. send_hid_report() now checks that
    before sending: in B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
2026-10-09 add the top plate STEP file for standalone pocket keyboard
2026-10-14 pref-kbd-standalone: add 1.5mm thick version of top plate
