cetola/pocket-reform-mirror/(notices)

Notices in the files:
pocket-reform-motherboard/pocket-reform-motherboard.kicad_sch:
License: OHL-S 2.0
